vmarzlin/ValTronix-VTM0001-EnergyMonitor/BOM.ods

Source: | C:\Users\Valéry\Documents\GitHub\VTM0001-EnergyMonitor\EnergyMonitor.sch
Date: | 14/07/2020 16:08:53
Tool: | Eeschema (5.1.6)-1
Generator: | C:\Program Files\KiCad\bin\scripting\plugins/bom_csv_grouped_by_value_with_fp.py
Component Count: | 130
Ref | Qnty | Value | Cmp name | Footprint | Description | Vendor
C1, C2, C3, C4, | 4 | 33nF | C | ValTronix:C_0805 | Unpolarized capacitor
C5, | 1 | 1µF | CP | ValTronix:CP_Elec_4x5.7 | Polarized capacitor
C6, C7, C21, C23, | 4 | 100nF | C | ValTronix:C_1206 | Unpolarized capacitor
C8, C13, C14, C15, C25, | 5 | 100nF | C | ValTronix:C_0805 | Unpolarized capacitor
C9, C10, | 2 | 22pF | C | ValTronix:C_0805 | Unpolarized capacitor
C11, | 1 | 1nF | C | ValTronix:C_0603 | Unpolarized capacitor
C12, | 1 | 10nF | C | ValTronix:C_0603 | Unpolarized capacitor
C16, C17, | 2 | 4.7µF | CP | ValTronix:CP_Radial_D10.0mm_P5.00mm | Polarized capacitor
C18, | 1 | 0.1µF | C | ValTronix:C_1206 | Unpolarized capacitor
C19, C20, | 2 | 47µF | CP | ValTronix:CP_Elec_6.3x7.7 | Polarized capacitor
C22, C24, | 2 | 10µF | CP | ValTronix:CP_Elec_4x5.7 | Polarized capacitor
C26, | 1 | C | C | ValTronix:C_0805 | Unpolarized capacitor
D1, D3, | 2 | 1N4007 | 1N4007 | ValTronix:D_DO-41_SOD81_P10.16mm_Horizontal | 1000V 1A General Purpose Rectifier Diode, DO-41
D2, | 1 | UF4005 | UF4005 | ValTronix:D_DO-41_SOD81_P10.16mm_Horizontal | 600V 1A Soft Recovery Ultrafast Rectifier Diode, DO-41
D4, | 1 | FS0103MA | FS01xxMA | ValTronix:TO-92_Inline_Narrow_Oval | 0.8A Ion, 600V Voff, 5-200µA Igt, Silicon Controlled Rectifier (Thyristor), TO-92
D5, | 1 | SMBJ5.0A | SMBJxxA | ValTronix:D_SMB | 600W unidirectional Transient Voltage Suppression Diode, DO214AA (SMB J-Bend)
DZ1, | 1 | BZV55C3V9 | BZV55Cxxx | ValTronix:D_MiniMELF | 500mW Zener Diode, 2.4-75V, 5%, MiniMELF
FB1, FB2, FB3, FB6, | 4 | BLM18PG121SN1D | Ferrite_Bead_Small | ValTronix:L_0805 | Ferrite bead, small symbol
FB4, FB5, | 2 |  | Ferrite_Bead_Small | ValTronix:L_FB_BL01 | Ferrite bead, small symbol
H1, | 1 | Nin | MountingHole_Pad | Mounting_Holes:MountingHole_3.2mm_M3_ISO14580_Pad | Mounting Hole with connection
H2, | 1 | Nout | MountingHole_Pad | Mounting_Holes:MountingHole_3.2mm_M3_ISO14580_Pad | Mounting Hole with connection
H3, H4, H5, H6, | 4 | M2 | MountingHole | Mounting_Holes:MountingHole_2.2mm_M2_ISO14580 | Mounting Hole without connection
J1, | 1 | IN | Screw_Terminal_01x02 | ValTronix:TerminalBlock_bornier-2_P5.08mm | Generic screw terminal, single row, 01x02, script generated (kicad-library-utils/schlib/autogen/connector/)
J2, | 1 | OUT | Screw_Terminal_01x02 | ValTronix:TerminalBlock_bornier-2_P5.08mm | Generic screw terminal, single row, 01x02, script generated (kicad-library-utils/schlib/autogen/connector/)
J4, | 1 | UART | Conn_01x04 | ValTronix:Pin_Header_Straight_1x04_Pitch2.54mm | Generic connector, single row, 01x04, script generated (kicad-library-utils/schlib/autogen/connector/)
J5, | 1 | Conn_01x06 | Conn_01x06 | ValTronix:Pin_Header_Straight_1x06_Pitch2.54mm | Generic connector, single row, 01x06, script generated (kicad-library-utils/schlib/autogen/connector/)
J6, | 1 | 5V | Conn_01x02 | ValTronix:Pin_Header_Straight_1x02_Pitch2.54mm | Generic connector, single row, 01x02, script generated (kicad-library-utils/schlib/autogen/connector/)
J7, | 1 | 3V3 | Conn_01x02 | ValTronix:Pin_Header_Straight_1x02_Pitch2.54mm | Generic connector, single row, 01x02, script generated (kicad-library-utils/schlib/autogen/connector/)
JP1, | 1 | Jumper | Jumper | Pin_Headers:Pin_Header_Straight_1x02_Pitch2.54mm | Jumper, normally closed
L1, | 1 | 1800µH | L_Core_Ferrite | ValTronix:L_Bourns_SDR1006 | Inductor with ferrite core
L2, | 1 | 10µH | L_Core_Ferrite | ValTronix:L_1210 | Inductor with ferrite core
LD1, LD2, LD3, LD4, | 4 | LED_0805 | LED_0805 | ValTronix:LED_0805 | Light emitting diode
MOV1, | 1 | MOV-10D420K | MOV-10DxxxK | ValTronix:RV_Disc_D12_W4.5_P7.5 | Metal Oxide Varistor
NT1, | 1 | 0 | Net-Tie_2 | ValTronix:R_0805 | Net tie, 2 pins
Q1, | 1 | 2N3906 | 2N3906 | ValTronix:TO-92_Inline_Narrow_Oval | -0.2A Ic, -40V Vce, Small Signal PNP Transistor, TO-92
R1, | 1 | 2m | R | ValTronix:R_2512 | Resistor
R2, R3, R8, R9, R12, R13, R15, R17, R21, R22, R23, R24, | 12 | 1k | R | ValTronix:R_0805 | Resistor
R4, R5, R6, | 3 | 330k | R | ValTronix:R_MicroMELF_MMU-0102 | Resistor
R7, | 1 | 9.1k | R | ValTronix:R_MicroMELF_MMU-0102 | Resistor
R10, R11, | 2 | 4.7k | R | ValTronix:R_0805 | Resistor
R14, R16, | 2 | 2k | R | ValTronix:R_0805 | Resistor
R18, R19, | 2 | 10k | R | ValTronix:R_0805 | Resistor
R20, | 1 | 200 | R | ValTronix:R_0805 | Resistor
R25, | 1 | 100 | RFP | ValTronix:R_Axial_DIN0414_L11.9mm_D4.5mm_P15.24mm_Horizontal | Flameproof Resistor
R26, | 1 | 560 | R | ValTronix:R_0805 | Resistor
R27, | 1 | 100 | R | ValTronix:R_0805 | Resistor
R28, | 1 | 33k | R | ValTronix:R_0805 | Resistor
R29, | 1 | 12k | R | ValTronix:R_0805 | Resistor
R30, | 1 | 30k | R | ValTronix:R_0805 | Resistor
R31, R32, R33, | 3 | R | R | ValTronix:R_0805 | Resistor
RF1, | 1 | 8.2 | RF | ValTronix:R_Axial_DIN0414_L11.9mm_D4.5mm_P15.24mm_Horizontal | Flameproof Fuse Resistor
SYM1, SYM3, | 2 | 230V | SYM_Flash_Large | ValTronix:Symbol_HighVoltage_Silk | Flash symbol, large
SYM2, | 1 | SYM_ESD_Large | SYM_ESD_Large | Symbols:ESD-Logo_8.9x8mm_SilkScreen | ESD warning/"Do not touch" symbol, large
TP1, | 1 | 5V | TestPoint_Flag | Measurement_Points:Measurement_Point_Square-SMD-Pad_Big | test point (alternative flag-style design)
TP2, | 1 | ~RESET | TestPoint | Measurement_Points:Measurement_Point_Round-SMD-Pad_Small | test point
TP3, | 1 | 4MHz | TestPoint_Probe | Measurement_Points:Measurement_Point_Round-SMD-Pad_Small | test point (alternative probe-style design)
TP4, | 1 | Temp | TestPoint_Probe | Measurement_Points:Measurement_Point_Round-SMD-Pad_Small | test point (alternative probe-style design)
TP5, | 1 | I | TestPoint_2Pole | Measurement_Points:Test_Point_2Pads | 2-polar test point
TP6, | 1 | V | TestPoint_2Pole | Measurement_Points:Test_Point_2Pads | 2-polar test point
TP7, | 1 | Test | TestPoint_Probe | Measurement_Points:Measurement_Point_Round-SMD-Pad_Small | test point (alternative probe-style design)
TP8, | 1 | Vref | TestPoint_Flag | Measurement_Points:Measurement_Point_Round-SMD-Pad_Small | test point (alternative flag-style design)
TP9, | 1 | V+ | TestPoint | Measurement_Points:Test_Point_Keystone_5019_Minature | test point
TP10, | 1 | +3V3A | TestPoint_Flag | Measurement_Points:Measurement_Point_Square-SMD-Pad_Big | test point (alternative flag-style design)
TP11, | 1 | L | TestPoint | Measurement_Points:Measurement_Point_Square-SMD-Pad_Small | test point
TP12, | 1 | N | TestPoint | Measurement_Points:Measurement_Point_Round-TH_Big | test point
TP13, | 1 | GNDA | TestPoint_Alt | Measurement_Points:Measurement_Point_Round-TH_Big | test point (alternative shape)
TP14, | 1 | Vz | TestPoint | Measurement_Points:Measurement_Point_Round-SMD-Pad_Small | test point
TP15, | 1 | GND | TestPoint | Measurement_Points:Measurement_Point_Round-TH_Big | test point
TP16, | 1 | +3V3D | TestPoint_Flag | Measurement_Points:Measurement_Point_Square-SMD-Pad_Big | test point (alternative flag-style design)
TP17, | 1 | VCC | TestPoint | Measurement_Points:Measurement_Point_Square-SMD-Pad_Big | test point
TP18, | 1 | GNDD | TestPoint_Alt | Measurement_Points:Measurement_Point_Round-TH_Big | test point (alternative shape)
TP19, | 1 | Cr | TestPoint_Probe | Measurement_Points:Measurement_Point_Round-SMD-Pad_Small | test point (alternative probe-style design)
U1, | 1 | MCP39F501 | MCP39F501 | ValTronix:QFN-28-1EP_5x5mm_Pitch0.5mm | Power Monitor, Calculation and Energy Accumulation, UART, 16-bit, QFN-28
U2, | 1 | MCP9700AT-ETT | MCP9700AT-ETT | ValTronix:SOT-23 | Low power, analog thermistor temperature sensor, ±2C accuracy, -40C to +125C, in SOT-23-3
U3, U4, | 2 | H11L1SM | H11L1SM | ValTronix:SMDIP-6_W9.53mm | Schmitt Trigger Output Optocoupler, High Speed, Open-Collector, SO-6, 1.6mA turn on threshold
U5, | 1 | PC827 | PC827 | ValTronix:DIP-8_W7.62mm | Dual DC Optocoupler, Vce 35V, CTR 50%, DIP-8
U6, | 1 | PC817 | PC817 | ValTronix:DIP-4_W7.62mm | DC Optocoupler, Vce 35V, CTR 50-300%, DIP-4
U7, | 1 | 74LVC1G14 | 74LVC1G14 | ValTronix:SOT-353_SC-70-5 | Single Schmitt NOT Gate, Low-Voltage CMOS
U9, | 1 | TL431DBZ | TL431DBZ | ValTronix:SOT-23 | Shunt Regulator, SOT-23
U10, | 1 | LNK3202P | LNK3202P | ValTronix:PDIP-8C | LinkSwitch-TN2 Family, 80mA Output Current, DIP-8C
U11, | 1 | PC817 | PC817 | ValTronix:DIP-4_W7.62mm_LongPads | DC Optocoupler, Vce 35V, CTR 50-300%, DIP-4
U12, | 1 | AMS1117-3.3 | AMS1117-3.3 | ValTronix:SOT-223-3_TabPin2 | 1A Low Dropout regulator, positive, adjustable output, SOT-223
U13, | 1 | BD4830G | BD48xxG | ValTronix:SSOP-5_2.9x2.8mm_Pitch0.95mm | Standard CMOS Voltage Detector IC, Open Drain Output, SSOP5
X1, | 1 | SG-310 | SG-310 | Oscillators:Oscillator_SMD_SeikoEpson_SG8002CE-4pin_3.2x2.5mm | CMOS Crystal Oscillator SPXO, SMD package 3.2x2.5mm²
Y1, | 1 | 4MHz | Crystal | ValTronix:Crystal_HC49-4H_Vertical | Two pin crystal
