vmarzlin/ValTronix-VTM0001-EnergyMonitor/Simulation/Filtrage TNY.asc

C1: cap; 470n
C2: polcap; 6.8µ; V=63 Irms=1.73205 Rser=0.075 Lser=0
C3: polcap; 6.8µ; V=63 Irms=500m Rser=0.17 Lser=0
D1: diode
D2: diode
D3: diode
D4: diode
D5: diode; 1SR154-600
D6: diode; RF05VA1S
L1: ind; 1m
M1: nmos; STN3N45K3
R1: res; 8.2
R2: res; 1k
R3: res; 100
V1: voltage; SINE(0 325 50)
V2: voltage; PULSE(0 10 0 50n 50n 5µ 15µ); Rser=100
Named nets: N, P, 0, Vdc, Out, G
.tran 100m startup
