vmarzlin/ValTronix-VTM0001-EnergyMonitor/Simulation/PSU_3v3.asc

C1: cap; 0.01µ; V=500 Irms=231m Rser=0.373094 Lser=0 mfg="KEMET" pn="C0805C103KCRAC" type="X7R"
C2: cap; 0.47µ; V=200 Irms=3.46 Rser=0.0302434 Lser=0 mfg="KEMET" pn="C2220C474K2RAC" type="X7R"
C3: polcap; 470µ; V=50 Irms=1.49 Rser=0.044 Lser=0 mfg="United Chemi-Con" pn="LXF50VB471M12X25LL" type="Al electrolytic"
C4: polcap; 10µ; V=35 Irms=0 Rser=0.3 Lser=0 mfg="AVX" pn="TPSD106M035R0300" type="Tantalum"
C5: cap; 33n
C6: cap; 33n
C7: cap; 0.1µ; V=50 Irms=1.34 Rser=0.0989014 Lser=0 mfg="KEMET" pn="C0805C104K5RAC" type="X7R"
C8: cap; 0.1µ; V=50 Irms=1.34 Rser=0.0989014 Lser=0 mfg="KEMET" pn="C0805C104K5RAC" type="X7R"
C9: polcap; 10µ; V=35 Irms=0 Rser=0.3 Lser=0 mfg="AVX" pn="TPSD106M035R0300" type="Tantalum"
C10: cap; 0.1µ; V=50 Irms=1.34 Rser=0.0989014 Lser=0 mfg="KEMET" pn="C0805C104K5RAC" type="X7R"
C11: cap; 0.47µ; V=200 Irms=3.46 Rser=0.0302434 Lser=0 mfg="KEMET" pn="C2220C474K2RAC" type="X7R"
D1: zener; BZX84B15VL
D2: diode; RR1VWM6S
R1: res; 33
R2: res; 55
R3: res; 165
R4: res; 750k
R5: res; 750k
R6: res; 1k
R7: res; 1k
R8: res; 100
R9: res; 3.3k
U1: LT1117-3.3
V1: voltage; SINE(0 325 50)
Named nets: Vin, 0, 3v3d, P, N, Vp, Vn, 3v3a
.tran 500m
