vmarzlin/ValTronix-VTM0001-EnergyMonitor/EnergyMonitor.kicad_pcb

## KiCad design EnergyMonitor.kicad_pcb (2022-09-08)

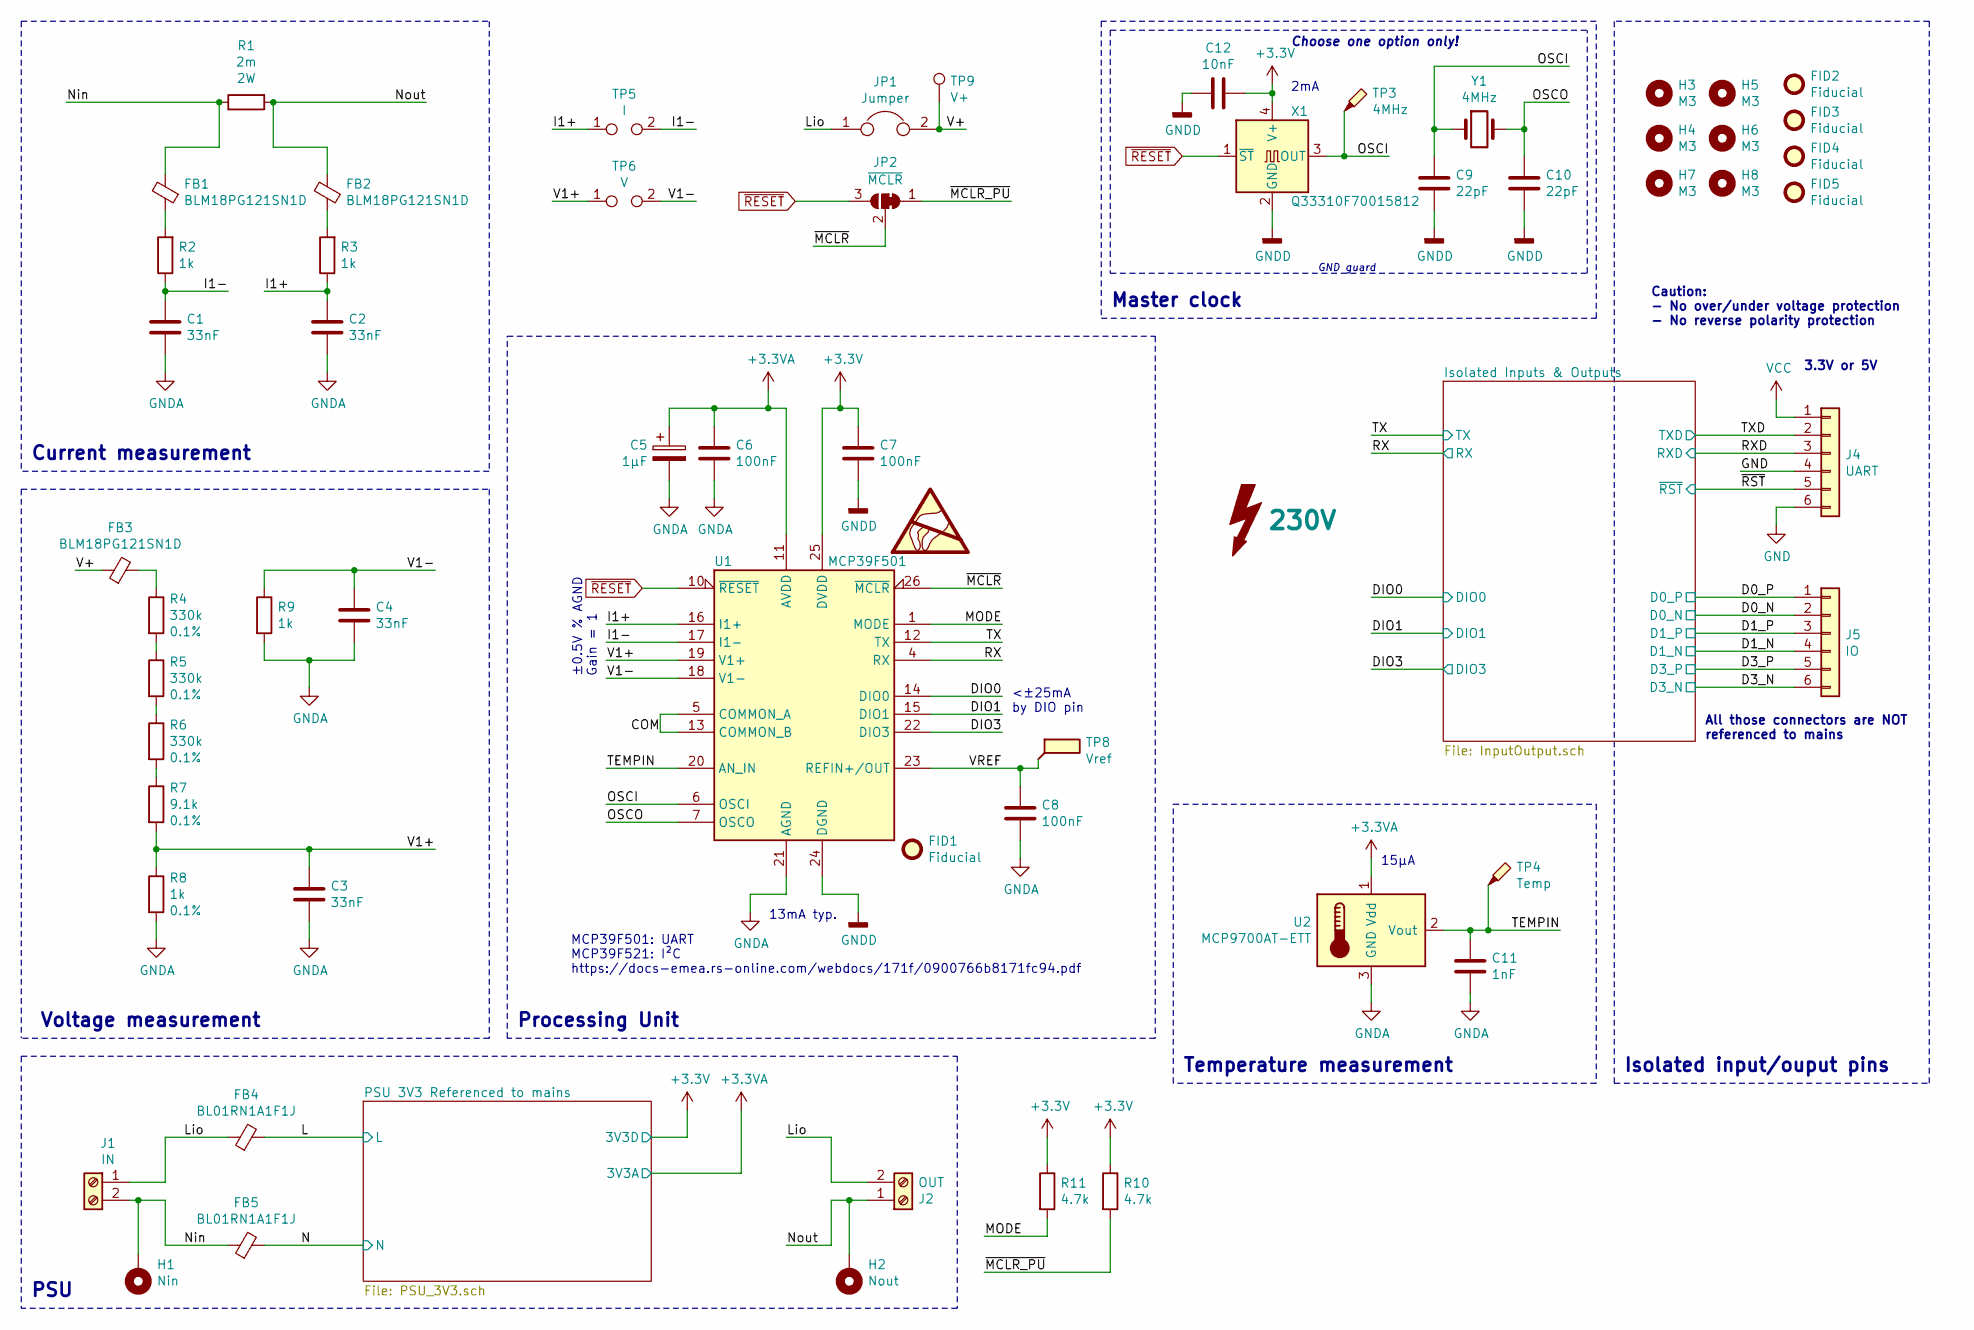
[picture p1: schematic EnergyMonitor.sch, Energy Monitor]

Parts:
C1, C2, C3, C4: 33nF; C_0805
C5: 1µF; CP_Elec_4x5.7
C6, C7: 100nF; C_1206
C8: 100nF; C_0805
C9, C10: 22pF; C_0805
C11: 1nF; C_0603
C12: 10nF; C_0603
FB1, FB2, FB3: BLM18PG121SN1D; L_0805
FB4, FB5: BL01RN1A1F1J; L_FB_BL01
FID1: Fiducial; Fiducial_0.5mm_Dia_1mm_Outer
FID2, FID3, FID4, FID5: Fiducial; Fiducial_1mm_Dia_2mm_Outer
H1: Nin; MountingHole_3.2mm_M3_ISO14580_Pad
H2: Nout; MountingHole_3.2mm_M3_ISO14580_Pad
H3, H4, H5, H6, H7, H8: M3; MountingHole_3.2mm_M3_DIN965
J1: IN; TerminalBlock_bornier-2_P5.08mm
J2: OUT; TerminalBlock_bornier-2_P5.08mm
J4: UART; Pin_Header_Straight_1x06_Pitch2.54mm
J5: IO; Pin_Header_Straight_1x06_Pitch2.54mm
JP1: Jumper; Pin_Header_Straight_1x02_Pitch2.54mm
JP2: ~MCLR; JP3_SMD_12closed
R1: 2m; R_2512
R2, R3, R8, R9: 1k; R_0805
R4, R5, R6: 330k; R_MicroMELF_MMU-0102
R7: 9.1k; R_MicroMELF_MMU-0102
R10, R11: 4.7k; R_0805
SYM1: 230V; Symbol_HighVoltage_Silk
SYM2: SYM_ESD_Large; ESD-Logo_8.9x8mm_SilkScreen
TP3: 4MHz; Measurement_Point_Round-SMD-Pad_Small
TP4: Temp; Measurement_Point_Round-SMD-Pad_Small
TP5: I; Test_Point_2Pads
TP6: V; Test_Point_2Pads
TP8: Vref; Measurement_Point_Round-SMD-Pad_Small
TP9: V+; Test_Point_Keystone_5019_Minature
U1: MCP39F501; QFN-28-1EP_5x5mm_Pitch0.5mm
U2: MCP9700AT-ETT; SOT-23
X1: Q33310F70015812; Oscillator_SMD_SeikoEpson_SG8002CE-4pin_3.2x2.5mm
Y1: 4MHz; Crystal_HC49-4H_Vertical

Connections:
+3.3VA: C5.1, C6.1, U1.11 (AVDD), U2.1 (Vdd); also elsewhere on the board
/COM: U1.5 (COMMON_A), U1.13 (COMMON_B)
/D0_N: J5.2; also elsewhere on the board
/D0_P: J5.1; also elsewhere on the board
/D1_N: J5.4; also elsewhere on the board
/D1_P: J5.3; also elsewhere on the board
/D3_N: J5.6; also elsewhere on the board
/D3_P: J5.5; also elsewhere on the board
/DIO0: U1.14 (DIO0); also elsewhere on the board
/DIO1: U1.15 (DIO1); also elsewhere on the board
/DIO3: U1.22 (DIO3); also elsewhere on the board
/I1+: C2.1, R3.1, TP5.1, U1.16 (I1+)
/I1-: C1.1, R2.1, TP5.2, U1.17 (I1-)
/L: FB4.2; also elsewhere on the board
/Lio: FB4.1, J1.1, J2.2, JP1.1
/MODE: R11.2, U1.1 (MODE)
/N: FB5.2; also elsewhere on the board
/Nin: FB1.2, FB5.1, H1.1, J1.2, R1.1
/Nout: FB2.2, H2.1, J2.1, R1.2
/OSCI: C9.1, TP3.1, U1.6 (OSCI), X1.3 (OUT), Y1.1
/OSCO: C10.1, U1.7 (OSCO), Y1.2
/RX: U1.4 (RX); also elsewhere on the board
/RXD: J4.3; also elsewhere on the board
/TEMPIN: C11.1, TP4.1, U1.20 (AN_IN), U2.2 (Vout)
/TX: U1.12 (TX); also elsewhere on the board
/TXD: J4.2; also elsewhere on the board
/V1+: C3.1, R7.2, R8.1, TP6.1, U1.19 (V1+)
/V1-: C4.1, R9.1, TP6.2, U1.18 (V1-)
/V+: FB3.1, JP1.2, TP9.1
/VREF: C8.1, TP8.1, U1.23 (REFIN+/OUT)
/~MCLR: JP2.2 (C), U1.26 (~MCLR)
/~MCLR_PU: JP2.1 (A), R10.2
/~RST: J4.5; also elsewhere on the board
GND: J4.4, J4.6; also elsewhere on the board
GNDA: C1.2, C2.2, C3.2, C4.2, C5.2, C6.2, C8.2, C11.2, R8.2, R9.2, U1.21 (AGND), U2.3 (GND); also elsewhere on the board
GNDD: C7.2, C9.2, C10.2, C12.2, U1.24 (DGND), U1.27 (DGND), U1.29 (DGND), X1.2 (GND); also elsewhere on the board
unnamed: FB1.1, R2.2
unnamed: FB2.1, R3.2
unnamed: FB3.2, R4.1
unnamed: R4.2, R5.1
unnamed: R5.2, R6.1
unnamed: R6.2, R7.1
VCC: J4.1; also elsewhere on the board
~RESET: JP2.3 (B), U1.10 (~RESET), X1.1 (~ST); also elsewhere on the board

Notes on the sheet:
MCP39F501: UART MCP39F521: I²C https://docs-emea.rs-online.com/webdocs/171f/0900766b8171fc94.pdf
13mA typ.
±0.5V % AGND Gain = 1
15µA
2mA
GND guard
3.3V or 5V
<±25mA by DIO pin
Isolated input/ouput pins
Current measurement
Voltage measurement
PSU
Temperature measurement
Processing Unit
Master clock
Caution: - No over/under voltage protection - No reverse polarity protection
All those connectors are NOT referenced to mains
Choose one option only!

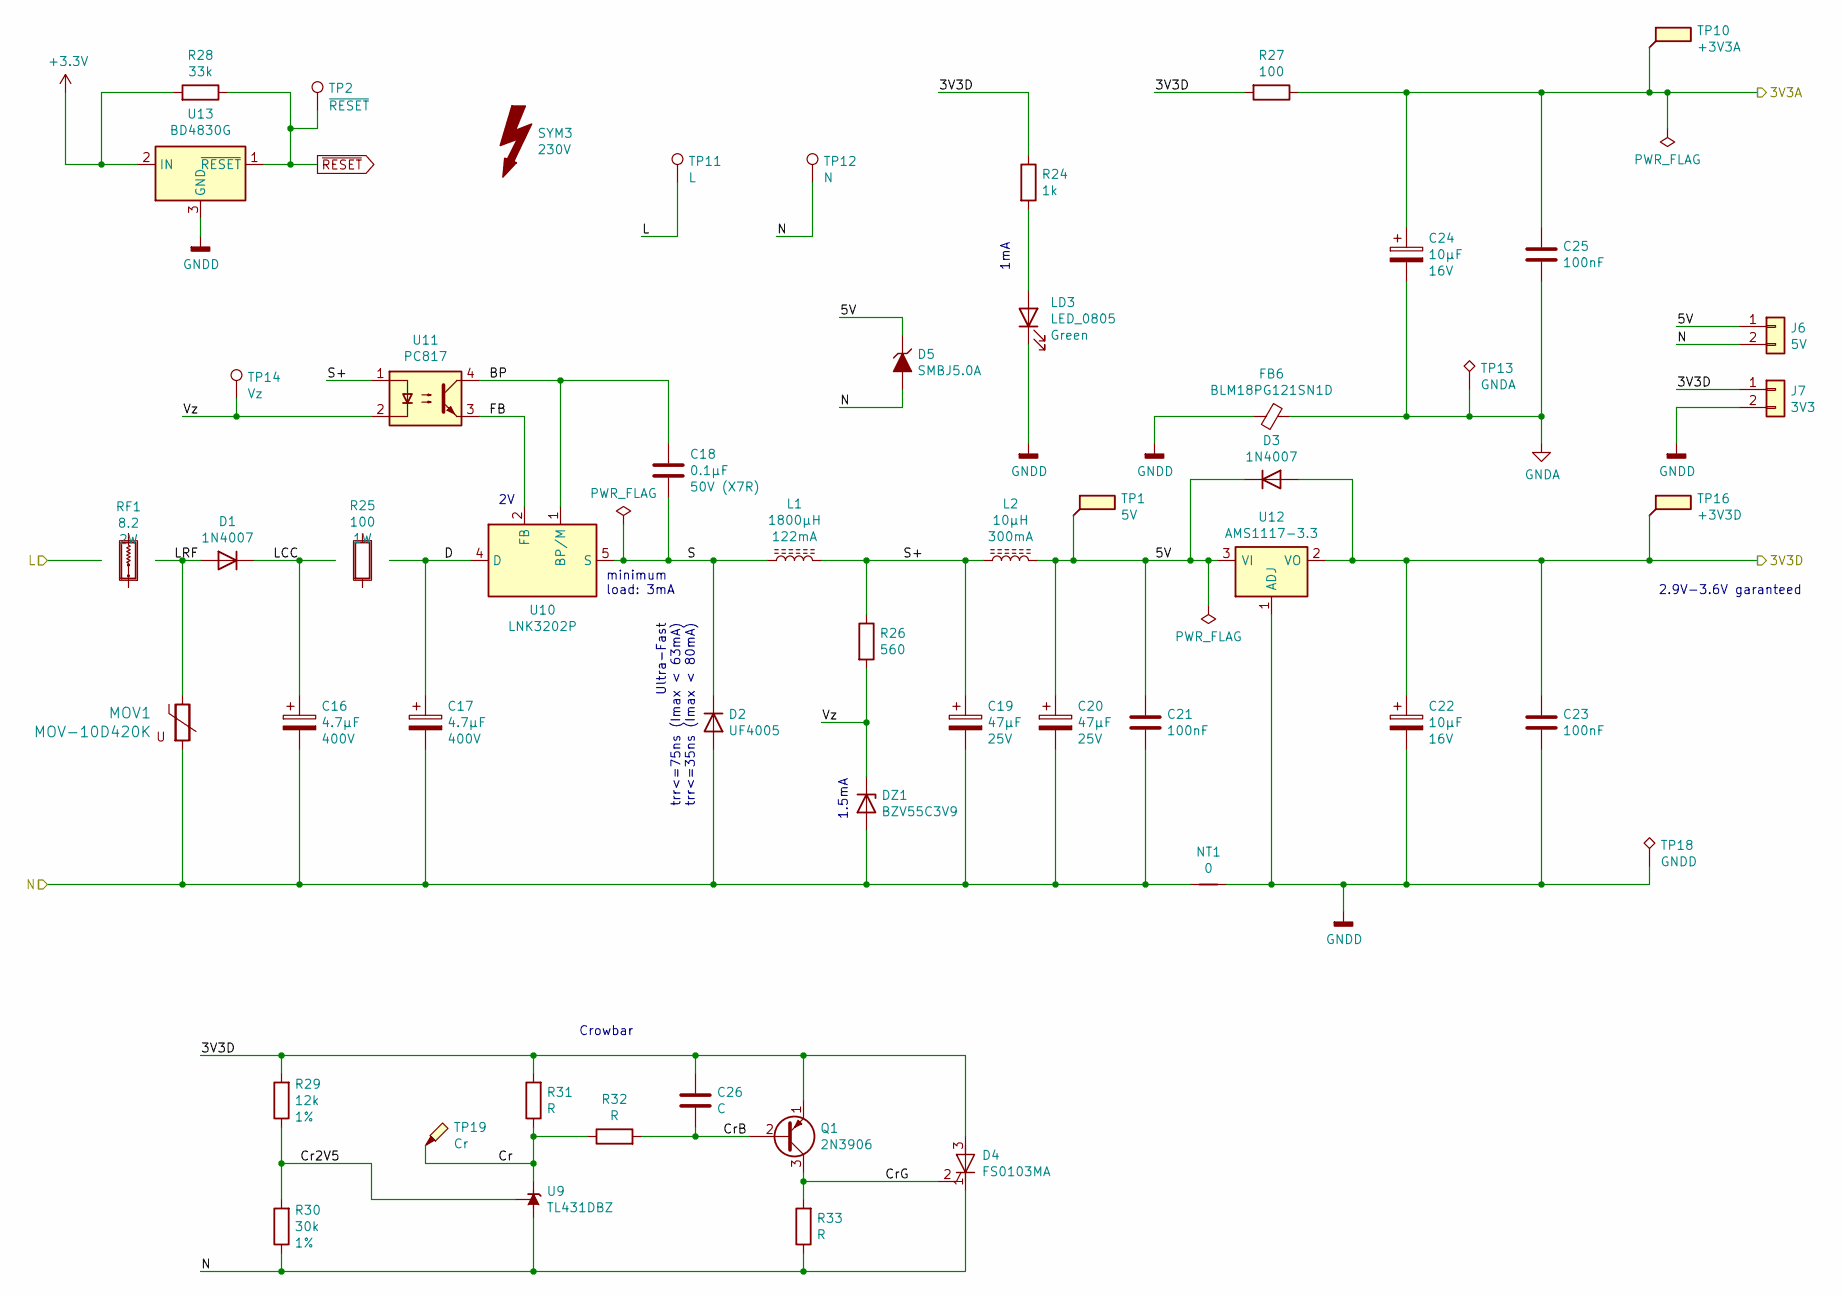
[picture p2: schematic PSU_3V3.sch, 3.3V 60mA power supply referenced to mains]

Parts:
C16, C17: 4.7µF; CP_Radial_D10.0mm_P5.00mm; Voltage 400V; Part ULD2G4R7MPD
C18: 0.1µF; C_1206; Voltage 50V (X7R); Part CL31B104KBCNNNL
C19, C20: 47µF; CP_Elec_6.3x7.7; Voltage 25V
C21, C23: 100nF; C_1206
C22, C24: 10µF; CP_Elec_4x5.7; Voltage 16V
C25: 100nF; C_0805
C26: C; C_0805
D1, D3: 1N4007; D_DO-41_SOD81_P10.16mm_Horizontal
D2: UF4005; D_DO-41_SOD81_P10.16mm_Horizontal
D4: FS0103MA; TO-92_Inline_Narrow_Oval
D5: SMBJ5.0A; D_SMB
DZ1: BZV55C3V9; D_MiniMELF
FB6: BLM18PG121SN1D; L_0805
J6: 5V; Pin_Header_Straight_1x02_Pitch2.54mm
J7: 3V3; Pin_Header_Straight_1x02_Pitch2.54mm
L1: 1800µH; L_Bourns_SDR1006; Part SDR1006-182KL
L2: 10µH; L_1210; Part LQH32CN100K23L
LD3: LED_0805
MOV1: MOV-10D420K; RV_Disc_D12_W4.5_P7.5
NT1: 0; R_0805
Q1: 2N3906; TO-92_Inline_Narrow_Oval
R24: 1k; R_0805
R25: 100; R_Axial_DIN0414_L11.9mm_D4.5mm_P15.24mm_Horizontal; Part # ROX2SJ100R
R26: 560; R_0805
R27: 100; R_0805
R28: 33k; R_0805
R29: 12k; R_0805
R30: 30k; R_0805
R31, R32, R33: R; R_0805
RF1: 8.2; R_Axial_DIN0414_L11.9mm_D4.5mm_P15.24mm_Horizontal; Part # PR02000208208JA100
SYM3: 230V; Symbol_HighVoltage_Silk
TP1: 5V; Measurement_Point_Square-SMD-Pad_Big
TP2: ~RESET; Measurement_Point_Round-SMD-Pad_Small
TP10: +3V3A; Measurement_Point_Square-SMD-Pad_Big
TP11: L; Measurement_Point_Square-SMD-Pad_Small
TP12: N; Measurement_Point_Round-TH_Big
TP13: GNDA; Measurement_Point_Round-TH_Big
TP14: Vz; Measurement_Point_Round-SMD-Pad_Small
TP16: +3V3D; Measurement_Point_Square-SMD-Pad_Big
TP18: GNDD; Measurement_Point_Round-TH_Big
TP19: Cr; Measurement_Point_Round-SMD-Pad_Small
U9: TL431DBZ; SOT-23
U10: LNK3202P; PDIP-8C
U11: PC817; DIP-4_W7.62mm_LongPads
U12: AMS1117-3.3; SOT-223-3_TabPin2
U13: BD4830G; SSOP-5_2.9x2.8mm_Pitch0.95mm

Connections:
+3.3VA: C24.1, C25.1, R27.1, TP10.1; also elsewhere on the board
/L: RF1.1, TP11.1; also elsewhere on the board
/N: C16.2, C17.2, C19.2, C20.2, C21.2, D2.2 (A), D4.1 (K), D5.2 (A2), DZ1.2 (A), J6.2, MOV1.2, NT1.2, R30.1, R33.1, TP12.1, U9.3 (A); also elsewhere on the board
/PSU 3V3 Referenced to mains/5V: C20.1, C21.1, D3.1 (K), D5.1 (A1), J6.1, L2.2, TP1.1, U12.3 (VI)
/PSU 3V3 Referenced to mains/BP: C18.1, U10.1 (BP/M), U11.4
/PSU 3V3 Referenced to mains/Cr: R31.1, R32.1, TP19.1, U9.1 (K)
/PSU 3V3 Referenced to mains/Cr2V5: R29.1, R30.2, U9.2 (REF)
/PSU 3V3 Referenced to mains/CrB: C26.2, Q1.2 (B), R32.2
/PSU 3V3 Referenced to mains/CrG: D4.2 (G), Q1.3 (C), R33.2
/PSU 3V3 Referenced to mains/D: C17.1, R25.2, U10.4 (D)
/PSU 3V3 Referenced to mains/FB: U10.2 (FB), U11.3
/PSU 3V3 Referenced to mains/LCC: C16.1, D1.1 (K), R25.1
/PSU 3V3 Referenced to mains/LRF: D1.2 (A), MOV1.1, RF1.2
/PSU 3V3 Referenced to mains/S: C18.2, D2.1 (K), L1.1, U10.5 (S), U10.6 (S), U10.7 (S), U10.8 (S)
/PSU 3V3 Referenced to mains/S+: C19.1, L1.2, L2.1, R26.1, U11.1
/PSU 3V3 Referenced to mains/Vz: DZ1.1 (K), R26.2, TP14.1, U11.2
GNDA: C24.2, C25.2, FB6.1, TP13.1; also elsewhere on the board
GNDD: C22.2, C23.2, FB6.2, J7.2, LD3.1 (K), NT1.1, TP18.1, U12.1 (ADJ), U13.3 (GND); also elsewhere on the board
unnamed: LD3.2 (A), R24.2
~RESET: R28.1, TP2.1, U13.1 (~RESET); also elsewhere on the board

Notes on the sheet:
Ultra-Fast trr<=75ns (Imax < 63mA) trr<=35ns (Imax < 80mA)
1.5mA
minimum load: 3mA
Crowbar
1mA
2.9V-3.6V garanteed

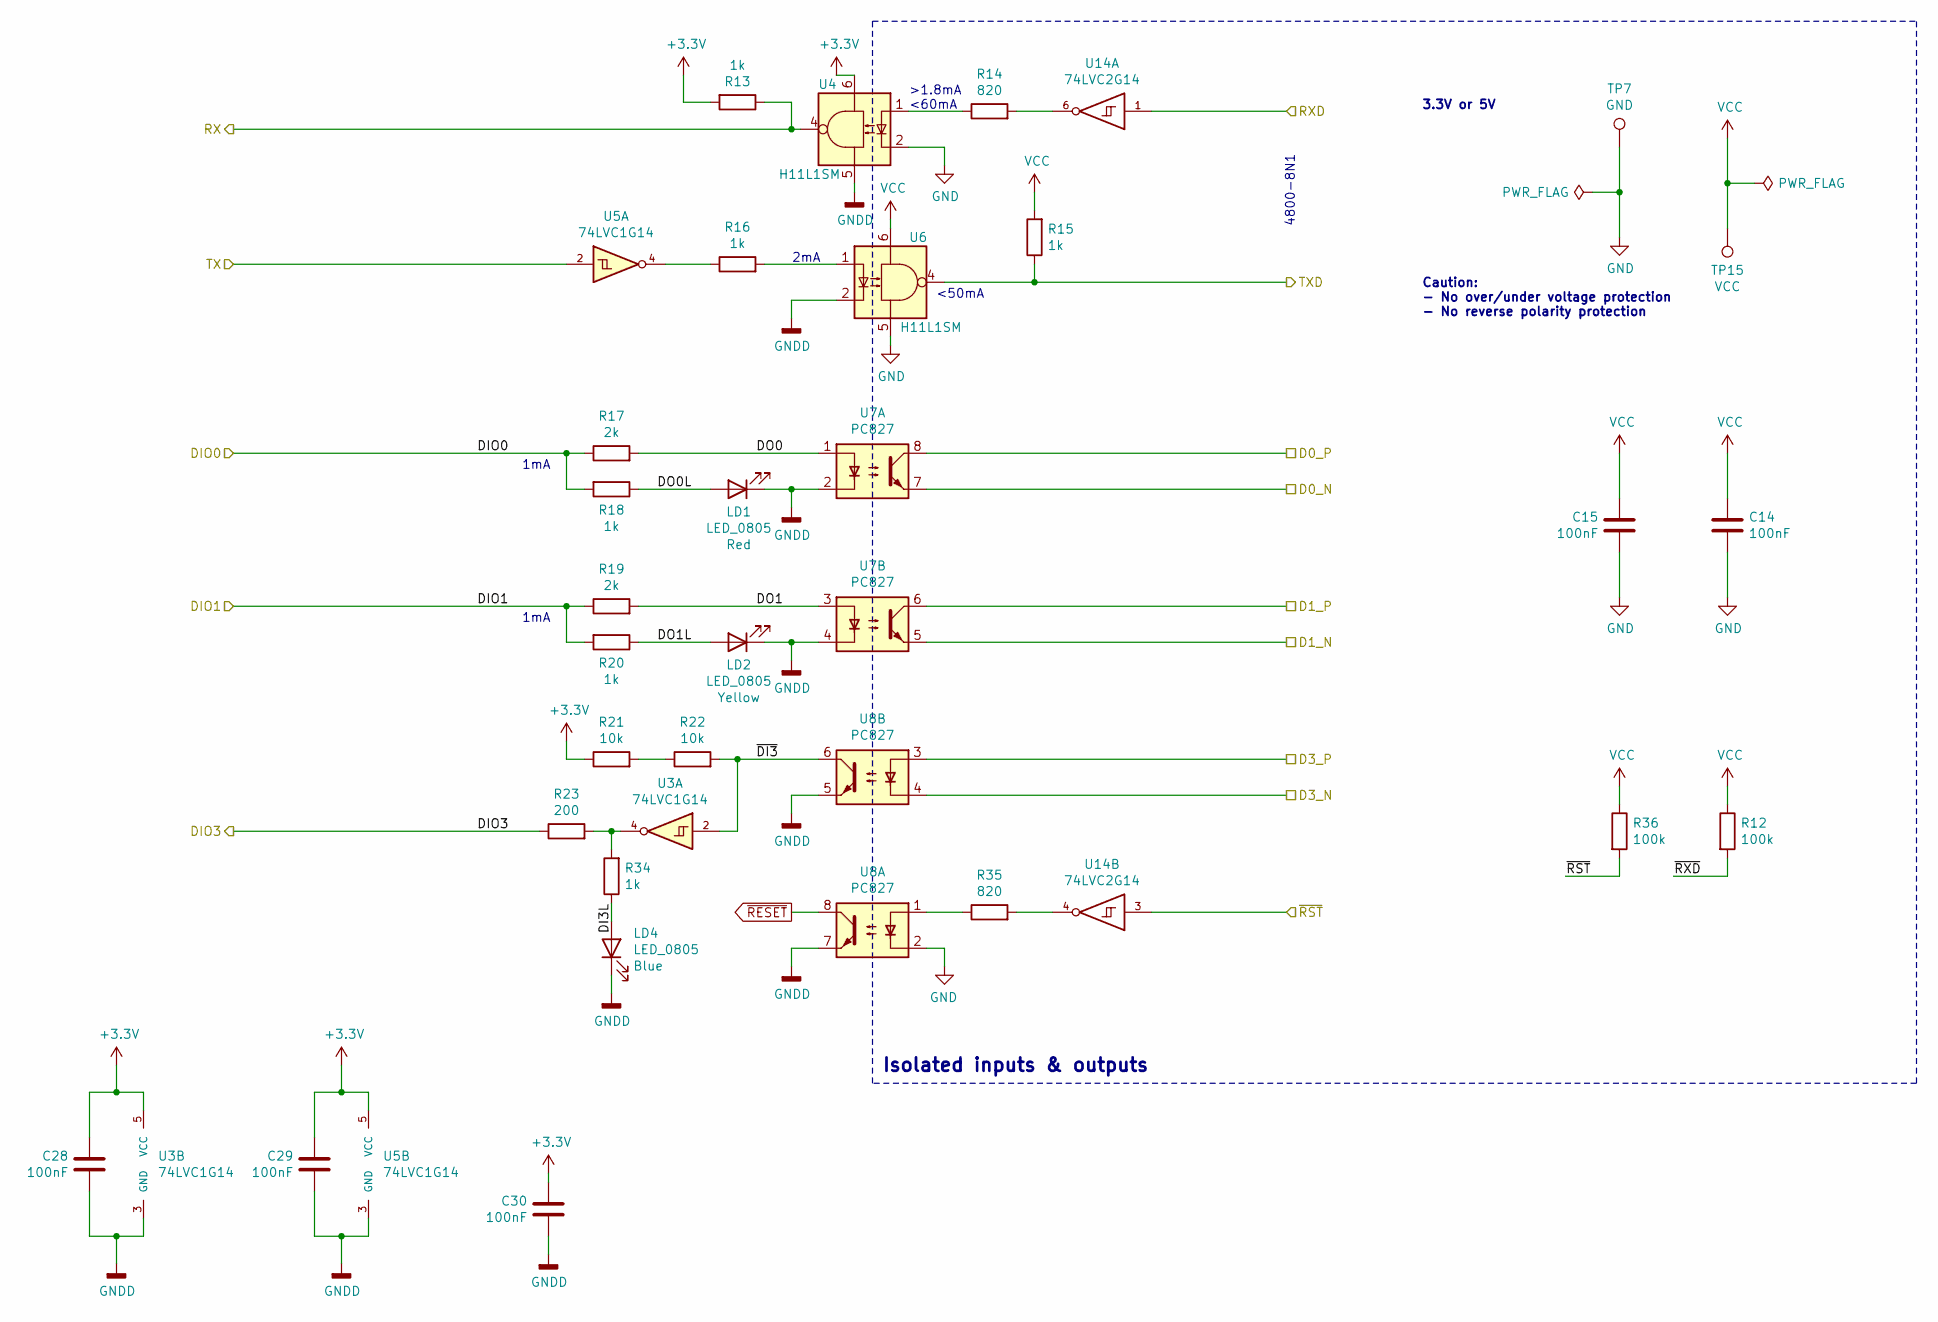
[picture p3: schematic InputOutput.sch, Isolated inputs & outputs]

Parts:
C14, C30: 100nF; C_0805; Part 08055C104KAT2A
C15: 100nF; C_0603; Part 08055C104KAT2A
C28, C29: 100nF; C_0603
LD1, LD2, LD4: LED_0805
R12, R36: 100k; R_0805
R13, R15, R16, R18, R20, R34: 1k; R_0805
R14, R35: 820; R_0805
R17, R19: 2k; R_0805
R21, R22: 10k; R_0805
R23: 200; R_0805
TP7: GND; Measurement_Point_Round-TH_Big
TP15: VCC; Measurement_Point_Square-SMD-Pad_Big
U3, U5: 74LVC1G14; SOT-25
U4, U6: H11L1SM; SMDIP-6_W9.53mm
U7, U8: PC827; SMDIP-8_W9.53mm
U14: 74LVC2G14; SOT-363_SC-70-6

Connections:
/D0_N: U7.7; also elsewhere on the board
/D0_P: U7.8; also elsewhere on the board
/D1_N: U7.5; also elsewhere on the board
/D1_P: U7.6; also elsewhere on the board
/D3_N: U8.4; also elsewhere on the board
/D3_P: U8.3; also elsewhere on the board
/DIO0: R17.1, R18.2; also elsewhere on the board
/DIO1: R19.1, R20.2; also elsewhere on the board
/DIO3: R23.1; also elsewhere on the board
/Isolated Inputs & Outputs/DI3L: LD4.2 (A), R34.1
/Isolated Inputs & Outputs/DO0: R17.2, U7.1
/Isolated Inputs & Outputs/DO0L: LD1.2 (A), R18.1
/Isolated Inputs & Outputs/DO1: R19.2, U7.3
/Isolated Inputs & Outputs/DO1L: LD2.2 (A), R20.1
/Isolated Inputs & Outputs/~DI3: R22.2, U3.2, U8.6
/Isolated Inputs & Outputs/~RXD: R12.2
/RX: R13.1, U4.4; also elsewhere on the board
/RXD: U14.1; also elsewhere on the board
/TX: U5.2; also elsewhere on the board
/TXD: R15.1, U6.4; also elsewhere on the board
/~RST: R36.2, U14.3; also elsewhere on the board
GND: C14.1, C15.1, TP7.1, U4.2, U6.5, U8.2, U14.2 (GND); also elsewhere on the board
GNDD: C28.2, C29.2, C30.2, LD1.1 (K), LD2.1 (K), LD4.1 (K), U3.3 (GND), U4.5, U5.3 (GND), U6.2, U7.2, U7.4, U8.5, U8.7; also elsewhere on the board
unnamed: R14.1, U4.1
unnamed: R14.2, U14.6
unnamed: R16.1, U5.4
unnamed: R16.2, U6.1
unnamed: R21.2, R22.1
unnamed: R23.2, R34.2, U3.4
unnamed: R35.1, U8.1
unnamed: R35.2, U14.4
VCC: C14.2, C15.2, R12.1, R15.2, R36.1, TP15.1, U6.6, U14.5 (VCC); also elsewhere on the board
~RESET: U8.8; also elsewhere on the board

Notes on the sheet:
2mA
1mA
4800-8N1
>1.8mA <60mA
<50mA
Isolated inputs & outputs
Caution: - No over/under voltage protection - No reverse polarity protection
3.3V or 5V

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
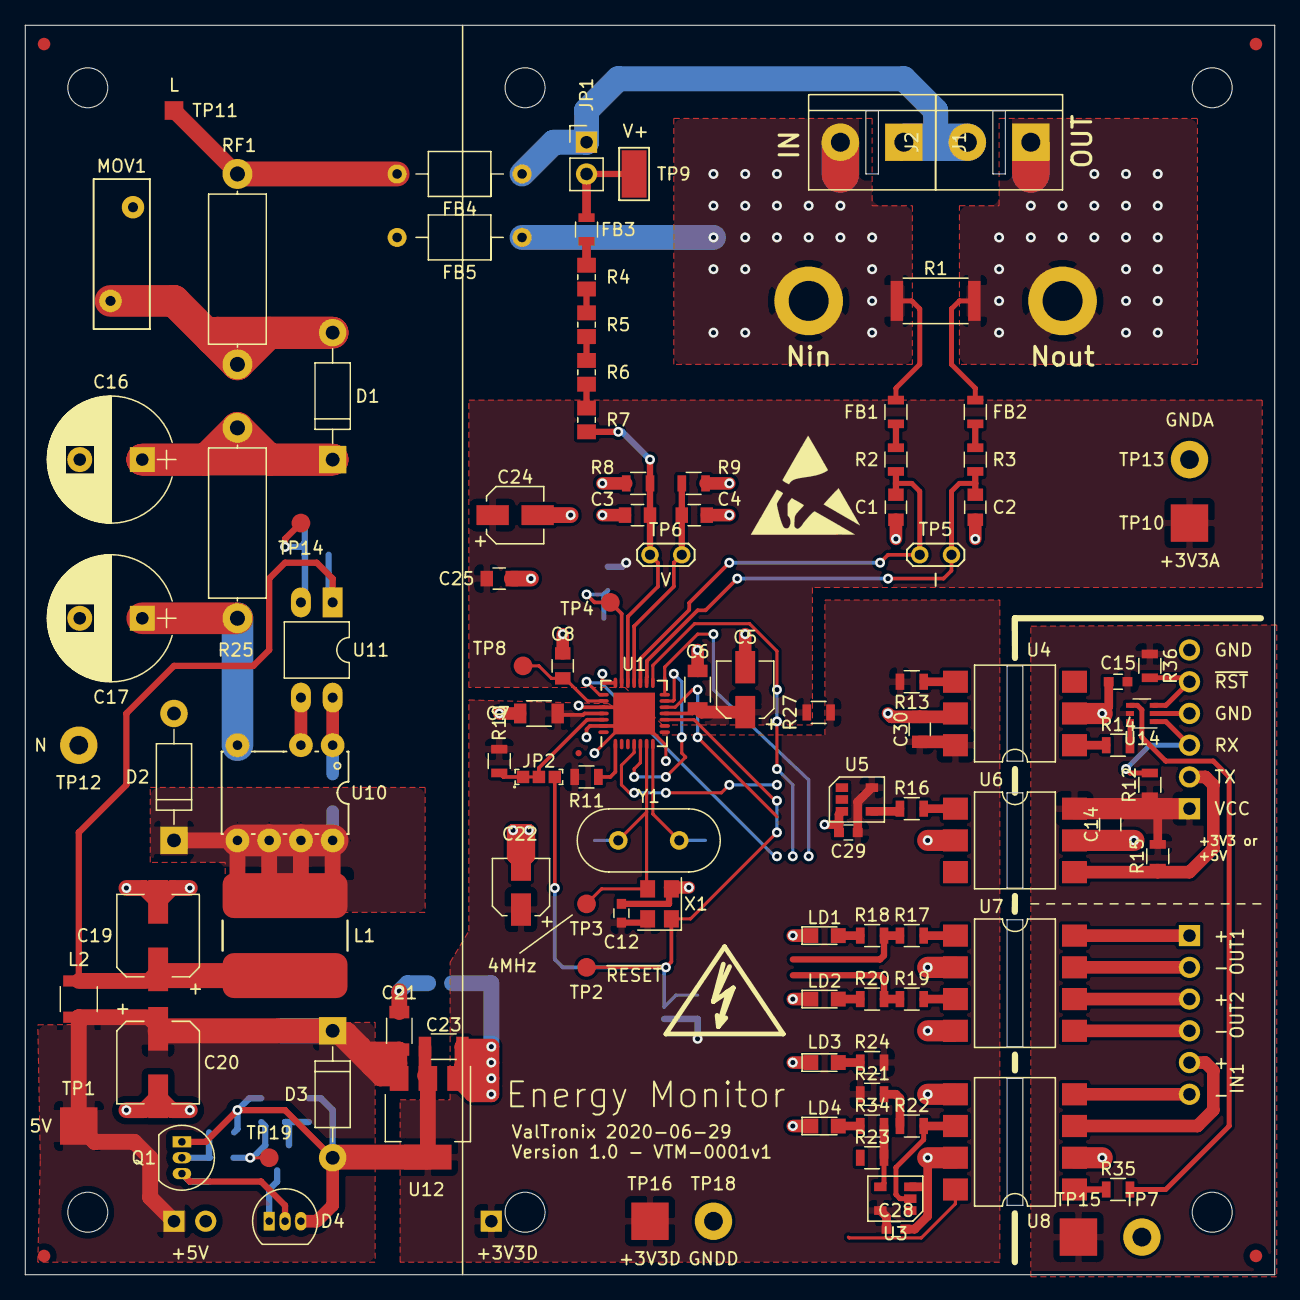
[picture p4: board EnergyMonitor.kicad_pcb from above]

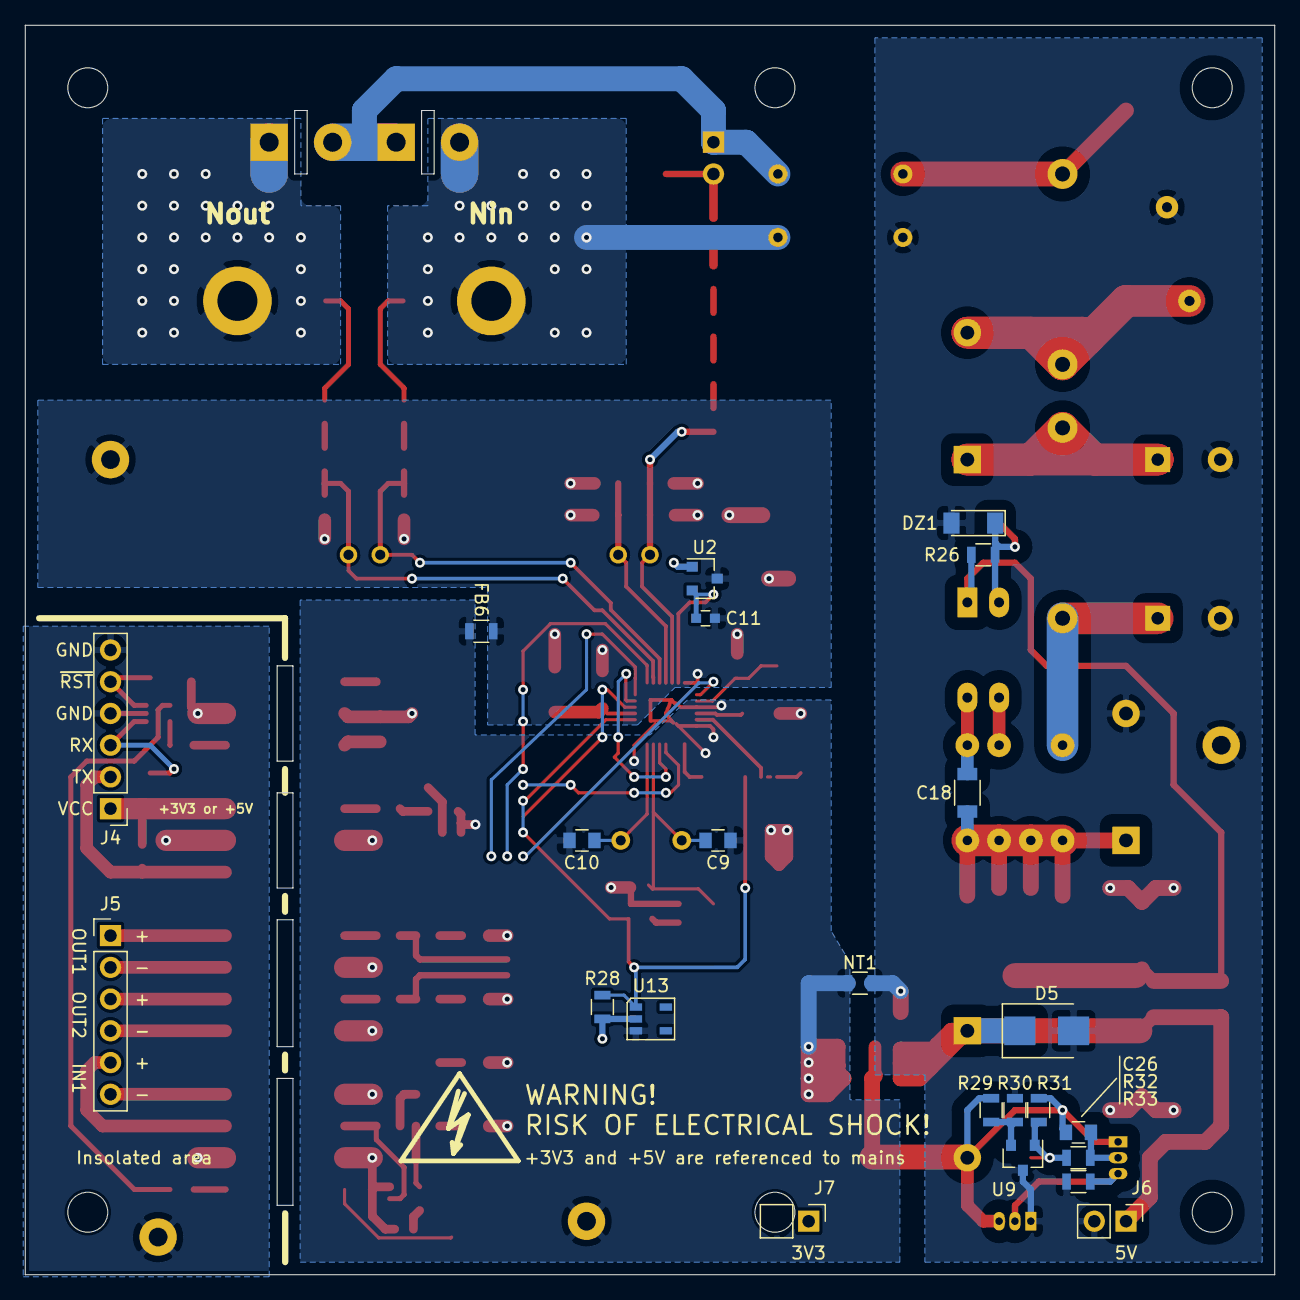
[picture p5: board EnergyMonitor.kicad_pcb from below]

Board: 2 copper layers, 100.0 x 100.0 mm, 144 parts (24 on the bottom side), 73 nets.
