vmarzlin/ValTronix-VTM0001-EnergyMonitor/(threads)

Thread 1 (2020-12-04):

Wrong footprint for BLM18PG121SN1D ferrite beads

vmarzlin, 2020-12-04:
FB1-FB3 and FB6 are [BLM18PG121SN1D](https://datasheet.octopart.com/BLM18PG121SN1D-Murata-datasheet-7623654.pdf) in the BOM. They are using ValTronix:L_0805 footprint on the PCB but should use ValTronix:L_0603.

Thread 2 (2020-12-04):

UART signals polarity is inverted

vmarzlin, 2020-12-04:
When idle, RX and TX should be high level as we can see on the diagram below:
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
Source of the image: [AmenophisIII, CC0, via Wikimedia Commons](https://commons.wikimedia.org/wiki/File:UART_Frame.svg)

The communication is not working with this issue as we can see on this capture (took on the output of an Arduino trying to communicate with this module):
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

Thread 3 (2020-12-27):

Increase mounting hole diameter

vmarzlin, 2020-12-27:
Hole diameter is actually using M2 screws, should be better to use M3 (drill at 3.2 or 3.3mm)

Closed 2021-03-05.

Thread 4 (2021-01-17):

Wrong resistance value between 3V3D and 3V3A

vmarzlin, 2021-01-17:
The resistance R27 is a 100Ω, it should be a 10Ω.

Thread 5 (2021-01-19):

Wrong footprint for 74LVC1G14 components

vmarzlin, 2021-01-19:
The reference used (in stock) is: 74LVC1G14W5-7 which is [SOT-25](https://www.torexsemi.com/file/SOT-25/SOT-25-pkg.pdf) package.
The footprint used on PCB is: SOT-353_SC-70-5 which is smaller.

**Footprint of all 74LVC1G14 components should be changed from SOT-353 to SOT-25.**
