vmarzlin/ValTronix-VTM0001-EnergyMonitor/(commit log)

2020-06-01 Initial commit
    DRC/ERC ok
    [EnergyMonitor.kicad_pcb, EnergyMonitor.sch, PSU_3V3.sch]
2020-06-24 Minor fixes
    Some typos
    Fix test point outline
    DRC/ERC pass
    [EnergyMonitor.kicad_pcb, EnergyMonitor.sch, PSU_3V3.sch]
2020-07-01 Préparation pour production
    [EnergyMonitor-B_Cu.gbr, EnergyMonitor-B_Mask.gbr, EnergyMonitor-B_Paste.gbr, EnergyMonitor-B_SilkS.gbr, EnergyMonitor-Dwgs_User.gbr, EnergyMonitor-Edge_Cuts.gbr, EnergyMonitor-F_Cu.gbr, EnergyMonitor-F_Mask.gbr]
2020-07-04 Applying Templace
    Change directories to follow ValTronix-VTM0000 Template
    [EnergyMonitor-B_Cu.gbr, EnergyMonitor-B_Mask.gbr, EnergyMonitor-B_Paste.gbr, EnergyMonitor-B_SilkS.gbr, EnergyMonitor-Dwgs_User.gbr, EnergyMonitor-Edge_Cuts.gbr, EnergyMonitor-F_Cu.gbr, EnergyMonitor-F_Mask.gbr]
2021-01-14 Ajout de la BOM
    [BOM.ods]
2022-09-08 Première version produite
    [EnergyMonitor.kicad_pcb, EnergyMonitor.sch, InputOutput.sch]
